ajinomoto124/FightStickProject/README.md

# FightStickProject
This is a custom built fightstick with personalized arduino firmware.  writeup.md contains details on the process and design decisions.
