ajinomoto124/FightStickProject/DSC00932.jpg

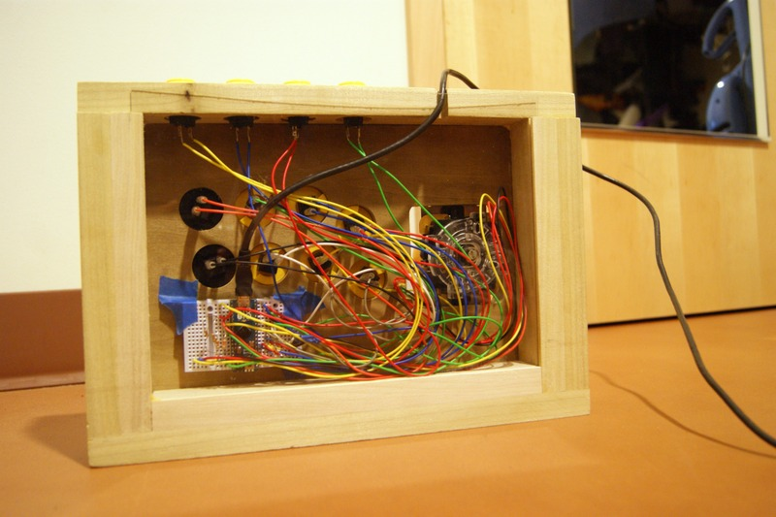
DSC00932.jpg
