ajinomoto124/FightStickProject/DSC00938.jpg

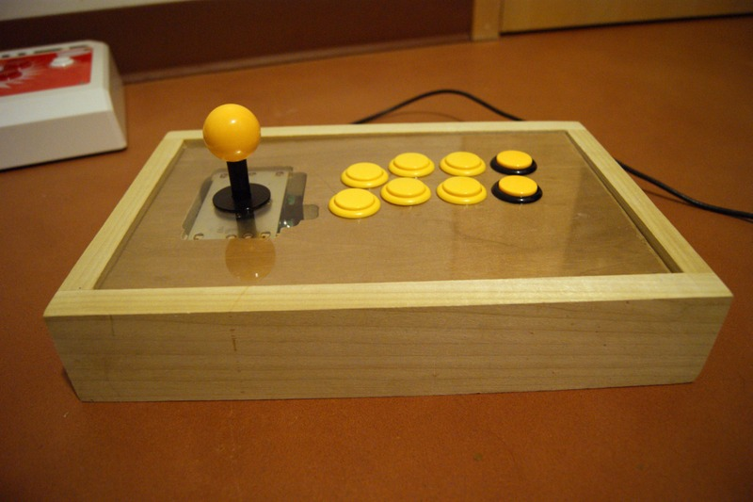
DSC00938.jpg
