ajinomoto124/FightStickProject/DSC00942.jpg

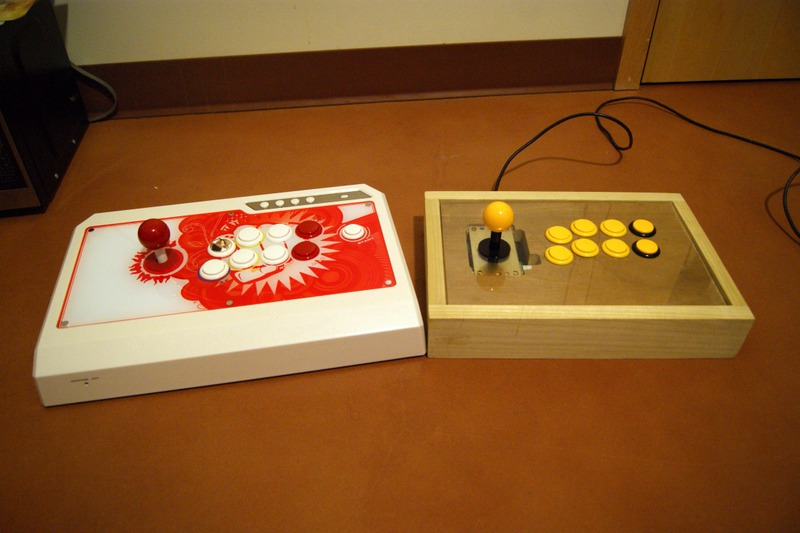
DSC00942.jpg
